GeekFunkLabs/stompbyte/stompbyte_schem.png

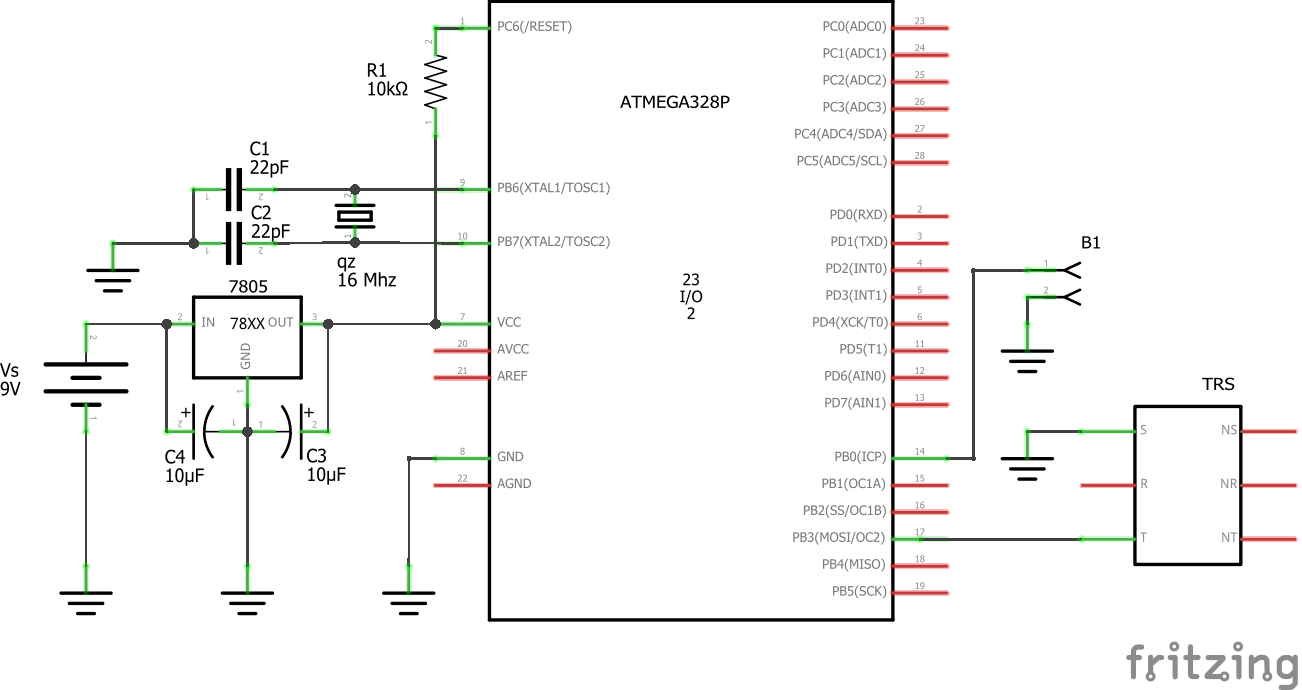
stompbyte_schem.png
