GeekFunkLabs/stompbyte/stompbyte.ino

#include "PCM.h"

const unsigned char deadkick[] PROGMEM = {
126, 125, 128, 124, 128, 124, 128, 122, 120, 118, 118, 112, 109, 109, 100, 95, 99, 86, 88, 83, 77, 80, 69, 75, 64, 78, 56, 87, 52, 91, 77, 41, 97, 104, 169, 121, 124, 144, 169, 182, 197, 210, 222, 236, 244, 255, 255, 255, 255, 255, 255, 255, 255, 255, 255, 255, 255, 255, 255, 246, 250, 229, 215, 206, 181, 164, 147, 135, 108, 100, 94, 64, 52, 31, 13, 6, 0, 0, 0, 0, 0, 0, 0, 0, 0, 0, 0, 0, 0, 0, 0, 0, 0, 0, 0, 0, 1, 14, 32, 30, 44, 60, 70, 77, 86, 100, 105, 117, 128, 135, 144, 151, 160, 167, 178, 181, 193, 192, 202, 207, 207, 220, 227, 223, 228, 236, 237, 245, 242, 248, 250, 248, 250, 255, 253, 248, 254, 252, 248, 244, 246, 241, 237, 236, 232, 227, 222, 218, 215, 208, 205, 201, 190, 190, 180, 178, 169, 167, 161, 155, 147, 139, 138, 128, 122, 114, 105, 104, 95, 94, 82, 75, 73, 66, 58, 56, 49, 45, 41, 35, 32, 30, 23, 24, 24, 19, 20, 16, 18, 18, 16, 16, 16, 22, 19, 24, 24, 27, 30, 31, 36, 37, 40, 47, 49, 53, 56, 61, 62, 66, 73, 74, 79, 83, 90, 92, 99, 99, 105, 108, 112, 117, 117, 124, 125, 130, 131, 133, 137, 137, 141, 141, 143, 143, 146, 147, 151, 147, 152, 151, 154, 156, 154, 159, 156, 160, 160, 161, 159, 161, 160, 163, 163, 163, 161, 164, 163, 165, 161, 165, 161, 165, 163, 163, 163, 161, 161, 161, 160, 161, 161, 159, 160, 159, 160, 158, 159, 158, 160, 159, 159, 158, 159, 156, 160, 159, 158, 159, 158, 160, 156, 160, 158, 159, 158, 156, 156, 155, 154, 152, 154, 148, 151, 148, 147, 148, 144, 144, 142, 141, 141, 139, 137, 135, 137, 131, 134, 130, 130, 128, 128, 128, 125, 125, 124, 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
28, 126, 126, 126, 126, 126, 126, 126, 126, 126, 126, 126, 126, 126, 126, 126, 126, 126, 126, 126, 126, 126, 126, 126, 126, 126, 126, 126, 126, 126, 126, 128, 126, 128, 126, 128, 126, 126, 126, 126, 126, 126, 126, 126, 126, 126, 126, 126, 128, 126, 126, 126, 126, 126, 126, 126, 126, 126, 126, 126, 126, 126, 126, 126, 126, 126, 126, 126, 126, 126, 126, 126, 126, 126, 128, 126, 128, 126, 126, 126, 126, 128, 126, 128, 126, 128, 126, 126, 126, 126, 128, 126, 128, 126, 126, 126, 126, 128, 126, 128, 126, 128, 126, 126, 128
};

const unsigned char electrokick[] PROGMEM = {
124, 126, 128, 126, 130, 151, 82, 166, 120, 92, 155, 106, 144, 119, 138, 117, 136, 123, 129, 129, 116, 125, 117, 112, 111, 119, 105, 114, 110, 119, 102, 133, 96, 133, 134, 88, 169, 134, 101, 163, 149, 136, 161, 152, 157, 159, 159, 163, 160, 165, 159, 153, 152, 146, 141, 136, 131, 124, 117, 115, 105, 104, 97, 90, 92, 78, 84, 70, 78, 75, 63, 81, 61, 69, 70, 74, 77, 79, 87, 92, 98, 102, 114, 116, 124, 133, 139, 143, 155, 157, 166, 169, 178, 180, 189, 190, 197, 201, 202, 209, 200, 219, 196, 219, 200, 207, 205, 190, 206, 181, 192, 174, 173, 161, 154, 144, 139, 128, 120, 111, 102, 95, 84, 82, 64, 72, 49, 58, 43, 36, 43, 26, 30, 21, 23, 21, 20, 21, 19, 23, 24, 32, 31, 40, 49, 50, 65, 69, 81, 93, 93, 116, 115, 131, 141, 147, 161, 164, 173, 188, 187, 196, 203, 208, 212, 215, 219, 223, 223, 226, 226, 225, 229, 226, 220, 224, 220, 215, 212, 208, 201, 205, 187, 187, 185, 167, 175, 158, 157, 146, 144, 134, 126, 124, 114, 114, 105, 101, 96, 93, 87, 81, 81, 74, 75, 68, 68, 65, 63, 60, 60, 59, 58, 59, 55, 59, 55, 59, 59, 64, 58, 66, 66, 65, 72, 68, 75, 75, 78, 78, 82, 82, 87, 88, 90, 93, 95, 97, 98, 104, 103, 107, 110, 114, 115, 120, 123, 123, 131, 131, 137, 139, 144, 150, 151, 159, 159, 165, 171, 171, 179, 180, 186, 189, 196, 196, 203, 204, 207, 210, 212, 216, 217, 216, 223, 221, 220, 220, 221, 217, 219, 216, 212, 214, 205, 206, 202, 194, 192, 183, 181, 171, 167, 158, 151, 145, 132, 128, 116, 111, 102, 93, 83, 76, 70, 60, 54, 46, 39, 33, 27, 19, 19, 12, 7, 6, 1, 0, 0, 0, 0, 0, 0, 0, 1, 2, 6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
};

const unsigned char kick808[] PROGMEM = {
126, 128, 126, 126, 126, 126, 126, 126, 126, 128, 126, 128, 124, 156, 232, 255, 255, 255, 255, 255, 255, 255, 255, 255, 250, 214, 172, 134, 102, 72, 44, 18, 0, 0, 0, 0, 0, 0, 0, 0, 0, 0, 0, 0, 0, 0, 0, 0, 0, 0, 0, 6, 30, 58, 84, 114, 150, 192, 228, 252, 255, 255, 255, 255, 255, 255, 255, 255, 255, 255, 255, 255, 255, 255, 255, 255, 255, 255, 255, 255, 255, 255, 255, 255, 255, 255, 255, 255, 255, 255, 255, 255, 255, 255, 255, 255, 255, 246, 240, 230, 222, 212, 204, 196, 186, 178, 168, 156, 148, 136, 128, 116, 106, 94, 84, 72, 60, 48, 34, 26, 12, 2, 0, 0, 0, 0, 0, 0, 0, 0, 0, 0, 0, 0, 0, 0, 0, 0, 0, 0, 0, 0, 0, 0, 0, 0, 0, 0, 0, 0, 0, 0, 0, 0, 0, 0, 0, 0, 0, 6, 20, 30, 44, 54, 68, 78, 92, 104, 116, 128, 138, 152, 164, 176, 188, 196, 210, 220, 228, 240, 248, 255, 255, 255, 255, 255, 255, 255, 255, 255, 255, 255, 255, 255, 255, 255, 255, 255, 255, 255, 255, 255, 255, 255, 255, 255, 255, 255, 255, 255, 255, 255, 255, 255, 255, 255, 255, 255, 255, 255, 255, 255, 255, 255, 255, 255, 255, 252, 246, 236, 232, 222, 214, 204, 198, 188, 182, 172, 164, 156, 146, 138, 130, 122, 112, 104, 92, 82, 76, 64, 56, 44, 34, 26, 14, 4, 0, 0, 0, 0, 0, 0, 0, 0, 0, 0, 0, 0, 0, 0, 0, 0, 0, 0, 0, 0, 0, 0, 0, 0, 0, 0, 0, 0, 0, 0, 0, 0, 0, 0, 0, 0, 0, 0, 0, 2, 14, 26, 34, 46, 56, 68, 76, 90, 98, 110, 118, 130, 138, 150, 160, 170, 180, 188, 196, 206, 214, 224, 232, 238, 246, 252, 255, 255, 255, 255, 255, 255, 255, 255, 255, 255, 255, 255, 255, 255, 255, 255, 255, 255, 255, 255, 255, 255, 255, 255, 255, 255,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
28, 130, 128, 130, 128, 130, 128, 130, 128, 130, 128, 130, 130, 128, 130, 128, 130, 130, 128, 130, 128, 130, 130, 130, 128, 128, 128, 126, 128, 126, 128, 126, 128, 128, 128, 126, 128, 126, 128, 126, 126, 128, 126, 126, 128, 126, 128, 126, 128, 126, 126, 126, 126, 126, 126, 128, 126, 128, 126, 128, 128, 126, 128, 126, 128, 128, 128, 126, 126, 126, 128, 126, 126, 126, 126, 126, 126, 126, 126, 126, 126, 126, 126, 128, 126, 128, 126, 128, 126, 128, 126, 128, 126, 126, 126, 126, 128, 126, 128, 126, 128, 126, 128, 126, 128, 126, 126, 126, 128, 126, 126, 126, 128, 126, 128, 126, 128, 126, 128, 126, 128, 128, 126, 128, 126, 126, 126, 128, 126, 128, 126, 126, 126, 126, 126, 126, 126, 128, 126, 126, 126, 128, 126, 128, 126, 126, 126, 126, 126, 126, 126, 126, 128, 126, 126, 126, 126, 126, 126, 126, 126, 126, 128, 126, 126, 126, 126, 128, 126, 126, 128, 126, 128, 126, 128, 128, 126, 128, 126
};

const unsigned char clave[] PROGMEM = {
140, 71, 149, 220, 4, 129, 248, 54, 57, 237, 141, 0, 182, 246, 21, 61, 255, 135, 1, 184, 217, 28, 94, 241, 106, 25, 202, 190, 25, 118, 233, 85, 47, 208, 166, 28, 140, 218, 70, 67, 214, 143, 33, 158, 204, 60, 86, 214, 124, 43, 173, 187, 53, 106, 211, 106, 55, 184, 169, 50, 125, 204, 90, 70, 192, 150, 51, 142, 194, 79, 85, 195, 134, 56, 155, 182, 71, 101, 194, 119, 65, 166, 170, 66, 115, 193, 105, 74, 175, 155, 65, 130, 188, 91, 88, 183, 136, 68, 146, 175, 84, 101, 181, 124, 77, 155, 163, 79, 115, 178, 112, 84, 163, 152, 79, 126, 173, 103, 92, 167, 141, 79, 137, 169, 96, 101, 170, 130, 84, 141, 159, 102, 103, 164, 134, 85, 143, 160, 95, 108, 166, 126, 89, 147, 153, 95, 118, 163, 118, 96, 152, 144, 94, 126, 160, 111, 102, 155, 136, 95, 135, 154, 106, 111, 156, 128, 97, 141, 149, 102, 118, 156, 120, 101, 146, 142, 101, 124, 154, 115, 106, 149, 137, 101, 130, 152, 112, 109, 150, 132, 101, 135, 148, 108, 117, 148, 126, 107, 137, 142, 109, 120, 147, 123, 111, 140, 137, 109, 126, 144, 119, 113, 141, 134, 109, 129, 143, 117, 115, 143, 130, 109, 132, 141, 113, 120, 143, 125, 112, 136, 137, 112, 124, 142, 121, 114, 138, 134, 112, 128, 142, 118, 117, 141, 130, 112, 131, 138, 117, 120, 141, 126, 113, 134, 137, 115, 123, 141, 125, 115, 136, 135, 114, 126, 140, 123, 119, 134, 131, 119, 126, 136, 124, 120, 134, 131, 118, 128, 134, 123, 124, 131, 129, 121, 129, 131, 123, 125, 131, 126, 121, 130, 130, 123, 125, 131, 125, 123, 130, 129, 123, 128, 131, 124, 124, 131, 128, 123, 129, 130, 125, 121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
};

const unsigned char sticks[] PROGMEM = {
148, 112, 110, 155, 108, 134, 142, 69, 117, 215, 108, 140, 71, 65, 200, 146, 88, 156, 137, 132, 9, 158, 231, 96, 128, 58, 202, 76, 45, 255, 114, 140, 93, 60, 221, 43, 155, 195, 76, 155, 55, 138, 167, 72, 186, 118, 92, 143, 99, 148, 120, 125, 145, 114, 105, 138, 130, 117, 130, 123, 130, 116, 124, 144, 118, 114, 128, 133, 124, 129, 122, 129, 121, 111, 137, 133, 121, 126, 122, 117, 129, 122, 137, 134, 114, 125, 123, 125, 133, 126, 128, 123, 120, 123, 122, 130, 133, 124, 119, 126, 125, 129, 125, 131, 133, 117, 122, 128, 126, 131, 122, 126, 128, 119, 126, 128, 129, 129, 123, 125, 128, 122, 131, 124, 125, 131, 121, 129, 125, 122, 133, 122, 125, 130, 123, 128, 119, 128, 133, 123, 126, 125, 126, 125, 120, 135, 129, 124, 128, 121, 132, 119, 128, 133, 121, 128, 121, 128, 129, 121, 135, 125, 124, 128, 120, 131, 122, 128, 130, 123, 125, 128, 124, 126, 124, 129, 126, 125, 126, 126, 128, 124, 129, 125, 128, 126, 125, 126, 125, 126, 126, 125, 128, 128, 125, 125, 125, 128, 128, 125, 128, 126, 128, 122, 129, 125, 128, 126, 124, 126, 124, 126, 128, 125, 129, 124, 125, 128, 124, 131, 126, 122, 128, 124, 129, 124, 126, 131, 125, 124, 128, 128, 129, 125, 128, 129, 122, 129, 126, 129, 128, 125, 128, 128, 124, 129, 125, 128, 128, 125, 128, 128, 128, 126, 128, 128, 125, 129, 128, 128, 125, 126, 129, 128, 128, 126, 129, 125, 124, 126, 130, 125, 124, 129, 128, 128, 123, 130, 129, 126, 125, 128, 128, 128, 126, 131, 125, 128, 125, 125, 129, 124, 129, 128, 123, 126, 126, 128, 128, 128, 131, 122, 125, 128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
};

const unsigned char tambourine[] PROGMEM = {
125, 126, 125, 126, 125, 126, 125, 125, 129, 123, 130, 121, 132, 119, 135, 114, 139, 113, 111, 114, 162, 129, 113, 255, 31, 140, 156, 105, 167, 142, 187, 102, 179, 46, 128, 206, 194, 95, 55, 244, 124, 128, 136, 123, 171, 138, 97, 150, 149, 142, 161, 107, 161, 112, 119, 150, 152, 134, 124, 190, 88, 145, 158, 105, 151, 108, 158, 152, 104, 149, 132, 134, 120, 161, 144, 126, 131, 113, 161, 117, 158, 125, 132, 145, 134, 121, 119, 148, 171, 116, 98, 166, 150, 143, 108, 124, 144, 139, 157, 147, 106, 131, 136, 153, 125, 133, 124, 154, 130, 134, 160, 102, 151, 119, 144, 129, 170, 110, 126, 166, 124, 110, 142, 158, 128, 147, 106, 151, 111, 163, 120, 116, 141, 143, 136, 124, 139, 133, 140, 121, 133, 138, 156, 108, 158, 112, 132, 158, 142, 107, 139, 154, 123, 148, 107, 176, 129, 108, 133, 151, 133, 119, 156, 112, 120, 153, 136, 122, 129, 154, 131, 116, 126, 124, 154, 132, 119, 117, 145, 131, 112, 147, 135, 139, 138, 134, 126, 106, 141, 130, 138, 120, 132, 153, 114, 147, 143, 113, 108, 147, 147, 110, 133, 138, 106, 148, 143, 138, 107, 132, 152, 115, 129, 123, 134, 122, 131, 136, 111, 121, 153, 129, 117, 128, 143, 116, 136, 151, 113, 125, 143, 121, 135, 130, 126, 122, 136, 148, 112, 142, 133, 135, 126, 124, 134, 144, 122, 135, 135, 136, 125, 128, 129, 121, 141, 114, 131, 136, 140, 126, 121, 126, 138, 123, 134, 113, 145, 132, 132, 144, 120, 138, 126, 121, 130, 139, 125, 124, 121, 134, 124, 144, 124, 124, 130, 124, 129, 131, 133, 134, 129, 117, 132, 138, 133, 130, 128, 131, 132, 129, 130, 13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
6, 128, 126, 128, 126, 128, 126, 128, 126, 128, 128, 126, 128, 126, 128, 126, 126, 128, 126, 128, 126, 128, 126, 128, 128, 126, 128, 126, 128, 126, 128, 128, 126, 128, 126, 126, 128, 126, 128, 128, 126, 128, 128
};

const unsigned char handclap[] PROGMEM = {
124, 128, 114, 124, 122, 141, 133, 131, 126, 114, 192, 83, 65, 91, 88, 204, 186, 126, 95, 102, 133, 84, 136, 198, 124, 98, 124, 145, 88, 107, 143, 128, 122, 128, 128, 108, 128, 124, 114, 124, 136, 122, 126, 124, 115, 107, 133, 136, 121, 122, 129, 112, 129, 128, 131, 115, 119, 122, 107, 121, 108, 140, 124, 131, 122, 129, 126, 115, 115, 115, 131, 122, 140, 141, 124, 105, 121, 114, 126, 124, 129, 126, 117, 121, 128, 126, 112, 112, 129, 131, 136, 119, 105, 131, 141, 122, 108, 121, 136, 129, 124, 124, 119, 124, 126, 122, 115, 128, 119, 119, 131, 119, 122, 124, 131, 122, 122, 133, 114, 124, 129, 124, 119, 128, 119, 117, 124, 133, 121, 128, 124, 124, 119, 122, 131, 115, 131, 126, 128, 115, 115, 129, 122, 126, 124, 131, 124, 126, 128, 119, 124, 122, 128, 126, 124, 114, 129, 126, 124, 122, 128, 122, 115, 129, 114, 129, 152, 185, 67, 13, 89, 255, 195, 5, 167, 112, 55, 159, 110, 167, 166, 105, 138, 126, 89, 34, 178, 190, 112, 67, 145, 148, 105, 110, 136, 143, 95, 178, 64, 122, 153, 133, 121, 107, 112, 100, 160, 193, 152, 81, 157, 25, 44, 209, 147, 126, 115, 121, 88, 115, 115, 157, 153, 179, 242, 27, 38, 76, 76, 105, 159, 141, 150, 152, 112, 134, 70, 117, 176, 143, 121, 134, 145, 114, 134, 136, 108, 91, 74, 126, 126, 145, 136, 150, 100, 100, 108, 86, 105, 114, 164, 183, 155, 98, 148, 169, 255, 70, 0, 77, 86, 65, 10, 145, 126, 255, 242, 162, 89, 17, 53, 148, 188, 166, 209, 122, 115, 77, 38, 76, 117, 171, 193, 169, 148, 114, 102, 86, 107, 126, 122, 126, 129, 117, 86, 143, 133, 145, 147, 13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
, 124, 126, 124, 126, 124, 126, 126, 124, 126, 124, 128, 124, 126, 124, 126, 126, 126, 124, 126, 124, 126, 126, 126, 124, 126, 124, 126, 126, 124, 126, 124, 126, 124, 126, 124, 126, 124, 126, 124, 126, 124, 126, 126, 126, 128, 126, 126, 126, 126, 126, 126, 126, 126, 126, 126, 126, 126, 128, 126, 126, 128, 126, 126, 126, 126, 126, 126, 126, 126, 126, 126, 126, 126, 126, 128, 126, 126, 126, 126, 126, 126, 126, 126, 126, 126, 126, 126, 126, 126, 128, 126, 126, 128, 128, 126, 128, 126, 126, 128, 126, 126, 126, 126, 126, 126, 126, 126, 126, 126, 126, 126, 126, 126, 126, 126, 126, 126, 126, 126, 126, 128, 126, 126, 126, 126, 126, 126, 126, 126, 126, 126, 126, 126, 126, 128, 126, 128, 126, 128, 126, 126, 126, 126, 126, 126, 126, 126, 126, 126, 126, 126, 126, 126, 126, 128, 126
};

const unsigned char smb_bump[] PROGMEM = {
126, 128, 126, 128, 126, 128, 126, 128, 126, 128, 126, 128, 126, 128, 128, 126, 128, 126, 128, 126, 128, 124, 129, 123, 132, 116, 188, 255, 234, 239, 228, 229, 219, 219, 213, 211, 206, 205, 200, 198, 193, 193, 187, 188, 182, 185, 164, 59, 59, 62, 65, 67, 70, 73, 73, 77, 78, 82, 82, 86, 85, 90, 88, 93, 90, 100, 86, 177, 226, 206, 213, 201, 205, 196, 198, 190, 192, 185, 187, 180, 182, 175, 178, 170, 175, 164, 177, 134, 39, 50, 49, 55, 57, 60, 64, 67, 68, 72, 73, 77, 77, 80, 82, 85, 85, 88, 88, 91, 91, 96, 200, 218, 206, 208, 200, 201, 193, 195, 188, 190, 183, 185, 178, 180, 173, 175, 170, 172, 167, 169, 162, 165, 155, 52, 37, 49, 47, 55, 54, 60, 60, 67, 65, 72, 70, 77, 75, 80, 78, 85, 83, 88, 86, 91, 88, 101, 205, 214, 206, 206, 200, 200, 193, 193, 188, 188, 182, 183, 177, 178, 173, 175, 169, 172, 165, 169, 162, 167, 149, 45, 41, 47, 47, 54, 54, 60, 60, 67, 65, 72, 70, 77, 75, 80, 78, 85, 82, 88, 85, 93, 86, 108, 211, 213, 206, 205, 200, 200, 193, 193, 188, 188, 182, 183, 177, 178, 173, 175, 169, 172, 165, 169, 160, 169, 141, 41, 42, 47, 49, 54, 55, 60, 60, 65, 65, 72, 70, 77, 75, 80, 78, 85, 83, 88, 86, 91, 88, 96, 90, 106, 208, 218, 208, 210, 201, 201, 195, 195, 190, 190, 185, 183, 180, 178, 177, 173, 173, 169, 170, 165, 167, 160, 165, 155, 167, 131, 34, 41, 44, 47, 52, 52, 59, 59, 64, 64, 70, 70, 73, 75, 78, 80, 82, 83, 85, 88, 86, 93, 88, 100, 83, 142, 224, 208, 211, 205, 203, 200, 195, 193, 190, 188, 183, 183, 178, 178, 175, 175, 170, 170, 169, 165, 165, 160, 164, 155, 169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
 126, 126, 126, 126, 126, 126, 126, 126, 126, 126, 126, 126, 126, 126, 126, 126, 126, 126, 126, 126, 126, 126, 126, 126, 126, 126, 126, 126, 126, 126, 126, 126, 126, 126, 126, 126, 126, 126, 128, 126, 128, 126, 128, 128
};
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
void loop() {
  int val=digitalRead(stompPin);

  // play a sound 
  if ((val != stompState) && (millis()-stompTime > debounceTime)) {
    stompState=val;
    if (kickStyle < 10) {
      if (stompState == LOW) {
        playKick();
      }
    } else {
      playPattern();
    }
    stompTime=millis();
  }

  // select sound/pattern
  if ((stompState == LOW) && (millis()-stompTime > holdSelectTime)) {
    if (++kickStyle > 12) {
      kickStyle=0;
    }
    if (kickStyle < 10) {
      playKick();
    } else {
      previewPattern();
    }
    while (digitalRead(stompPin) == LOW) {
    }
    stompState=HIGH;
    stompTime=millis();
  }
}
